Eric-FR/F9P_RAWX_Logger/SOFTWARE.md

# SOFTWARE

This guide describes how to install the Arduino IDE and all the libraries you will need for the RAWX_Logger_F9x.

The guide assumes you will be using Windows; the process would be slightly different under Linux or OSX.

## Arduino IDE

To begin, download and install the latest (or, at least 1.8.19) version of the [Arduino IDE](https://www.arduino.cc/en/Main/Software).
There are versions for Windows, Mac OS X and 32/64 bit Linux. The installation should be straight forward but there
are [step-by-step instructions](https://www.arduino.cc/en/Guide/HomePage) available if you need them.

The download page will ask you if you would like to make a donation to support Arduino. Please do make a donation if you can.

I recommend using the default options and selecting "Always trust software from Arduino AG" and "Always trust software from Adafruit" when asked.

Once installation is complete, the IDE should open and display a blank sketch.

## Install the Arduino and Adafruit SAMD Boards

A full guide on how to install the Arduino and Adafruit Boards is available on [the Adafruit website](https://learn.adafruit.com/adafruit-feather-m0-adalogger/setup)

In summary:
- Click on the File menu and then Preferences
- Add https://adafruit.github.io/arduino-board-index/package_adafruit_index.json to the "Additional Boards Manager URLs" box
- Click OK
- Click on the Tools menu, hover over the line which says "Board" and then click on "Boards Manager"
- Let the Boards Manager window update the list of available libraries
- Scroll down the list until you see "Arduino SAMD Boards (32-bits ARM Cortex-M0+) by Arduino"
- Hover over that line and click "Install"
- Wait for the installation to complete
- Scroll further down the list and install the "Adafruit SAMD Boards"
- Close the Boards Manager

URLs

Boards

You may see warning messages about "skipping script execution". You can ignore these.

Now quit the IDE.

## Blink

You can now connect your Adalogger board to your computer using a standard micro-USB cable. All being well,
you should hear Windows acknowledge the Adalogger. It should appear as a new COM port.

Restart the IDE. It will open with the same blank sketch as before.

Click on the Tools menu and hover over the line which says "Port". All being well you should see a line which
says "COM4 (Adafruit Feather M0)". The COM number may be different depending on how many devices you have attached.
Click on that line.

Port

Click on the Tools menu again and hover over the line which says "Board". Use the down arrow to scroll down to the
Adafruit SAMD boards. Click on the line which says "Adafruit Feather M0".

After a short delay, you should see the text in the bottom right corner of the IDE window
change to "Adafruit Feather M0 on COM4".

Board

Click on the File menu and hover over the line which says "Examples". Hover over the line which says "01.Basics"
and click on the entry which says "Blink".

A new IDE window should appear containing the Blink code. You can now close the IDE window that contains the blank
sketch, leaving only the Blink window open.

Click on the arrow icon below the Edit menu. This will compile the blink code and upload it onto the Adalogger.

All being well, the red LED on the Adalogger should start to blink once per second.

You may notice that the Adalogger COM port number has changed. This is normal. If you have problems please refer
to the [Adafruit tutorial](https://learn.adafruit.com/adafruit-feather-m0-adalogger/using-with-arduino-ide).

## Libraries

We now need to install some libraries that are required by the RAWX_Logger_F9x code.

### Adafruit GPS Library

RAWX_Logger_F9x uses the Adafruit GPS library to parse the standard NMEA messages output by the F9x to set the M0's
Real Time Clock (RTC).

Click on the Tools menu and then click "Manage Libraries". The Library Manager window will open.

Use the filter text box to search for "Adafruit GPS". Hover over the line which says "Adafruit GPS Library"
and click "Install".

### RTCZero

RAWX_Logger_F9x uses the Arduino RTCZero library to set the SAMD M0 RTC.

Use the library manager filter text box to search for "RTCZero". Hover over the line which says "RTCZero by Arduino"
and click "Install".

### Bill Greiman's SdFat

RAWX_Logger_F9x uses Bill Greiman's SdFat to access the Adalogger micro-SD card, write data to the RAWX log file rapidly
and set the create, write and access timestamps.

Use the library manager filter text box to search for "sdfat". Hover over the line which says "SdFat by Bill Greiman"
and click "Install".

### Adafruit NeoPixel Library

RAWX_Logger_F9x can use a NeoPixel to provide additional information during logging. You will need to install the Adafruit NeoPixel library
if you want to take advantage of this. By default, the NeoPixel needs to be connected to D13 (sharing the pin with the on-board red LED).

Use the library manager filter text box to search for "Adafruit NeoPixel". Hover over the line which says "Adafruit NeoPixel Library"
and click "Install".

### SparkFun Ublox Library

You need the [SparkFun U-blox GNSS v3 library](https://github.com/sparkfun/SparkFun_u-blox_GNSS_v3)
to communicate with the ZED-F9x over its I2C port.
All of the message configuration is done over I2C, leaving the UART port clear for the RAWX messages themselves.

Use the library manager filter text box to search for "SparkFun gnss".
Hover over the line which says "SparkFun u-blox GNSS v3" and click "Install". Be carefull to select **version 3**.

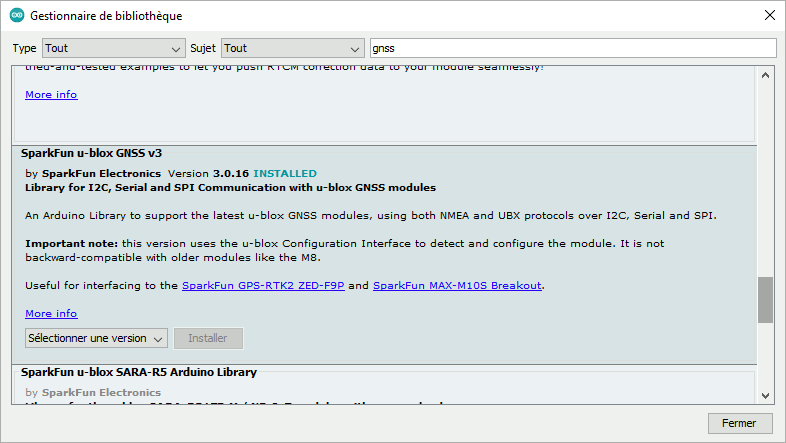
[picture p13: img/arduino_ide_select_ublox_v3.png]
SparkFun u-blox GNSS v3


You can now close the library manager.

## Download RAWX_Logger_F9x

You can find the logger code in the [Arduino folder](Arduino)

The best way to download the code is to clone the repository using GitHub Desktop. That way you can keep up to date with new versions.

If you don't want to do that, you can use the use the green "Clone or download" button on the main repo page to "Download ZIP" instead.
It depends on which browser you are using, but you should end up with a file called RAWX_Logger_F9x-master.zip in your
Downloads directory.

- Open File Explorer (right-click on the Windows icon in the bottom left corner of your screen then click on "File Explorer")
- Click on your "Downloads" quick access link
- Double-click on the RAWX_Logger_F9x-master.zip file
- Double-click on the RAWX_Logger_F9x-master folder
- Double-click on the Arduino folder
- Right-click on the RAWX_Logger_F9x folder and click "Copy"
- Click on your "Documents" quick access link
- Double-click on the "Arduino" folder
- Right-click and select "Paste"

All being well, you should now have a Documents\Arduino\RAWX_Logger_F9x folder containing (only) RAWX_Logger_F9x.ino

In the Ardino IDE, click on the File menu and then "Open...". When the file window opens double-click on the RAWX_Logger_F9x folder
and then double-click on the RAWX_Logger_F9x.ino file. The logger code will open in a new window. You can now close the Blink window.

## Next > [HARDWARE.md](HARDWARE.md)
