Eric-FR/F9P_RAWX_Logger/img/base_station.jpg

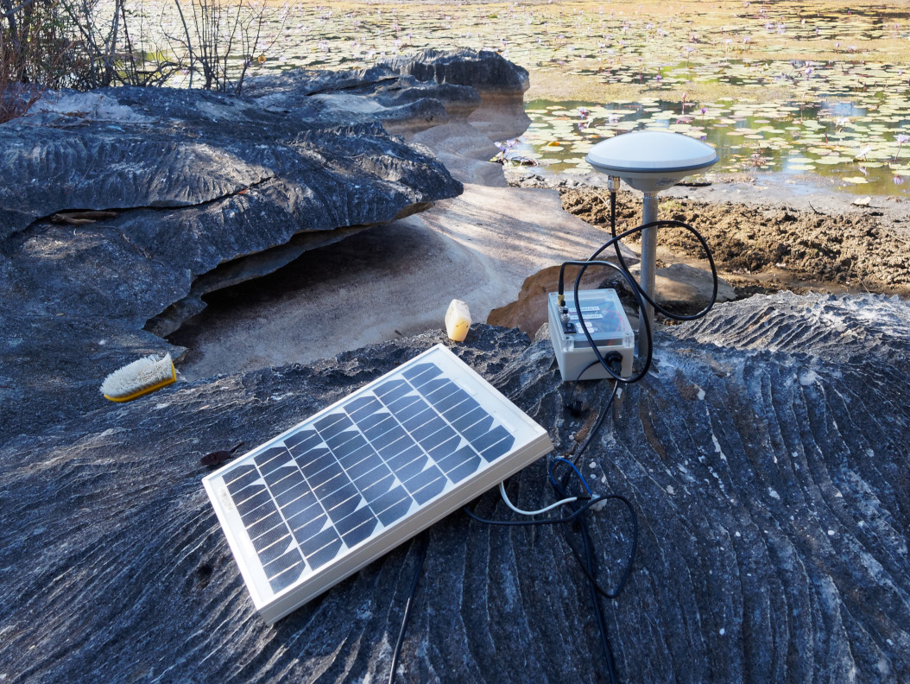
img/base_station.jpg
