Eric-FR/F9P_RAWX_Logger/img/boitier_bt_ptt.jpg

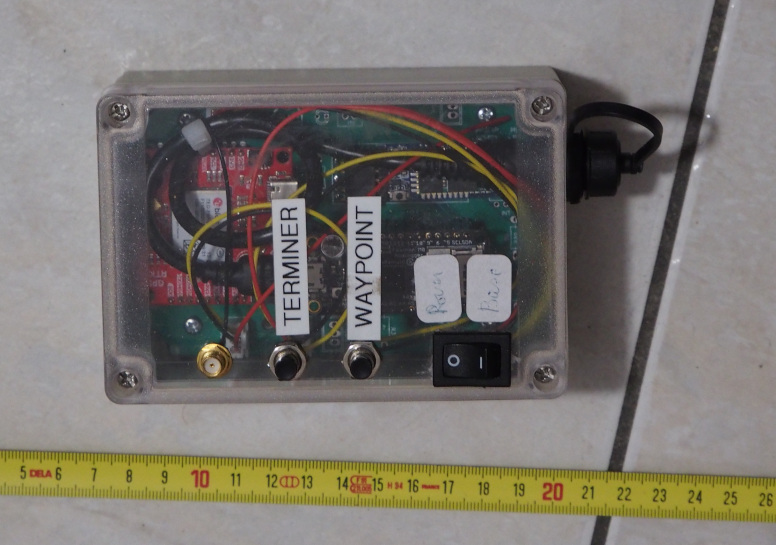
img/boitier_bt_ptt.jpg
