Eric-FR/F9P_RAWX_Logger/img/cave_entrance.jpg

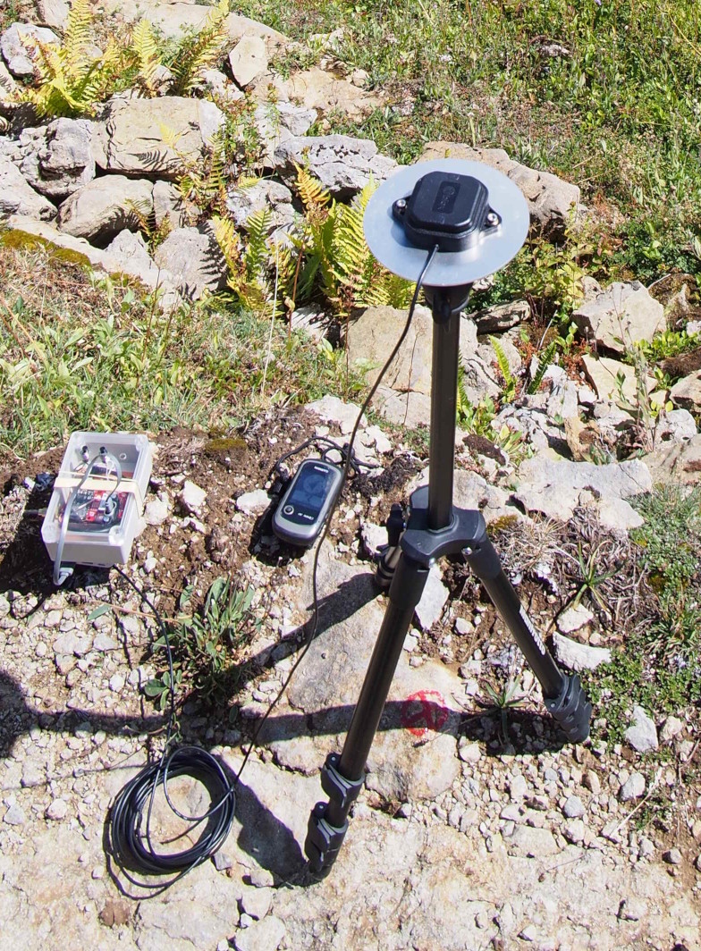
img/cave_entrance.jpg
