Eric-FR/F9P_RAWX_Logger/img/ublox_antenna_car.jpg

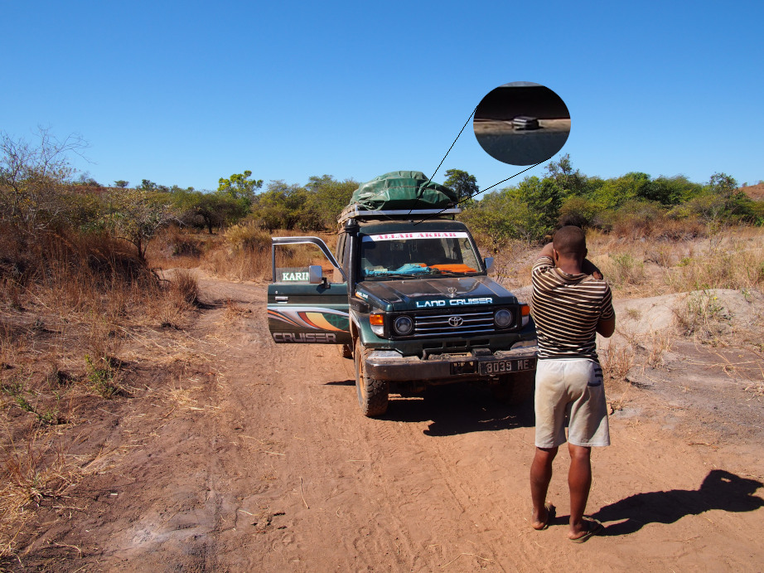
img/ublox_antenna_car.jpg
