Eric-FR/F9P_RAWX_Logger/(commit log)

2022-10-06 Update RAWX_Logger_F9P_I2C.ino
    Reduce SPI bus speed to 10 MHz to avoid data corruption on SD card
    [RAWX_Logger_F9P_I2C.ino]
2022-10-06 Update RAWX_Logger_F9P_I2C.ino
    Set F9P dynamic to Portable (default) and acquisition rate to 1 Hz.
2022-10-06 Update RAWX_Logger_F9P_I2C.ino
    Add NMEA GST sentences output on UART2
2023-10-26 Update RAWX_Logger_F9P_I2C.ino
    Added support for F9R
    Switch to SparkFun ublox librairy V3
2023-10-26 Delete RAWX_Logger_F9P.ino
    Removing original sketch not using I2C
2023-10-26 Update README.md with new picture of the device
    Replace picture of the electronic device
2023-10-28 Update README.md
    Change electrical wiring
2023-10-28 Update HARDWARE.md
    Add F9R and update description to current project status
2023-11-02 Update HARDWARE.md
    PCB
2023-11-02 Add PCB files
2023-11-02 Add PCB drawings
2023-11-02 Update HARDWARE.md
    Added PCB
2023-11-04 Update HARDWARE.md
    Added reference to author for PCB design.
2024-04-18 Holder for F9R data logger
    Holder to precisely and reproducibly install the logger inside the car (Dacia Lodgy). Made by laser engraving.
2024-04-18 Drawing for F9R logger casing
    For 3mm plywood
2024-05-03 Update RAWX_Logger_F9x.ino
    Adding Priority Navigation mode. Bug corrections.
    [RAWX_Logger_F9x.ino]
